elecdot/hardware-design/reports/README.md

# reports

这里存放课程报告输入材料、选题文档和图表。

## 索引

| 路径 | 用途 |
|---|---|
| [diagrams/](diagrams/) | 可编辑的架构和设计图。 |
| [final_defense_ppt_outline.md](final_defense_ppt_outline.md) | 最终答辩 PPT 大纲和 10 分钟硬件演示脚本。 |
| [i2c_jy901_midterm_ip_check.md](i2c_jy901_midterm_ip_check.md) | I2C JY901 模块的期中个人 IP 检查说明。 |
| [DOCX files](.) | 课程选题或报告文档。 |

仅用于报告表达的内容放在这里。会影响实现的工程事实应同步到 [../docs/](../docs/)。
