elecdot/hardware-design/reports/gzh/README.md

# gzh PPT materials

本目录包含可插入小组最终汇报的三段 PPT 源材料：

1. I2C JY901 九轴传感器。
2. PYNQ 侧融合与集成。
3. PC Server 侧集成服务。

文件：

| 文件 | 用途 |
|---|---|
| [ppt_three_sections.md](ppt_three_sections.md) | 三个部分可直接使用的 slide 文本和讲稿。 |
| [evidence_and_boundaries.md](evidence_and_boundaries.md) | 验证证据、demo 表述边界和可能的老师追问。 |
| [latex/](latex/) | 用于最终 PPT 图的 LaTeX/TikZ 源图。 |
| [diagrams/](diagrams/) | 作为轻量备份/参考保留的 Mermaid 源图。 |

这些文件有意不包含个人 overview 页和最终 summary 页，因为它们用于插入全组汇报流程。
