elecdot/hardware-design/reports/report/assert/README.md

# Report Image Asset Checklist

本目录存放报告正文引用的图片。

## 已存在

- `fig3-2-jy901-ip-architecture.png`
- `fig3-3-jy901-i2c-burst-read.svg`
- `fig3-1-jy901-single-module-path.svg`
- `fig3-5-jy901-pynq-driver-flow.svg`
- `fig3-8-jy901-ila-debug-top.svg`
- `fig3-11-pynq-software-integration.svg`
- `fig3-12-pc-service-module-design.svg`
- `fig4-2-system-architecture.svg`
- `fig4-5-pc-pynq-four-message-flow.svg`
- `fig4-6-pc-server-pipeline.svg`
- `fig4-7-board-client-sequence.svg`
- `fig4-8-system-test-layered-flow.svg`

其中部分文件复用了既有展示材料，新增的软件结构图为报告正文补充图。

## 仍需补充

- `fig3-4-vivado-jy901-ip-symbol.png`
- `fig3-6-jy901-simulation-pass.png`
- `fig3-7-jy901-i2c-waveform.png`
- `fig3-9-jy901-ila-debug-capture.png`
- `fig3-10-jy901-single-module-cli-pass.png`
- `fig4-1-final-system-photo.png`
- `fig4-3-vivado-block-design.png`
- `fig4-4-final-wiring-photo.png`
- `fig4-9-module-simulation-pass-summary.png`
- `fig4-10-vivado-address-map.png`
- `fig4-11-pynq-integrated-demo-output.png`
- `fig4-12-tft-live-dashboard-photo.png`
- `fig4-13-ir-ac-pynq-output.png`
- `fig4-14-ir-transmitter-ac-response-photo.png`
- `fig4-15-pc-dashboard-final-demo.png`
- `fig4-16-jsonl-four-record-streams.png`
- `fig4-17-final-demo-evidence-collage.png`
