elecdot/hardware-design/reports/diagrams/README.md

# diagrams

这里存放课程报告和设计说明使用的可编辑项目图。

## 索引

| 文件 | 用途 |
|---|---|
| [macro-design.drawio](macro-design.drawio) | 高层系统架构图。 |

当图表反映某个实现决策时，同步更新 [../../docs/](../../docs/) 中对应的文字文档。
