elecdot/hardware-design/vivado/ip_repo/ir_ac_axi/src/gree_ir_core.v

`timescale 1ns/1ns

/*
 * Raw Gree YB0F2 infrared transmit core.
 *
 * This core replays captured active-low mark/space waveforms for seven
 * 67-bit Gree YB0F2 commands. Software selects PRESET 1..7, then issues START.
 * The AXI command registers only expose the low 64 bits as compatibility
 * status; the actual transmitted waveform comes from this ROM.
 *
 * PRESET 1: power_on  0x1090040A400080016
 * PRESET 2: power_off 0x8050040A40008001C
 * PRESET 3: temp_24   0x9010040A400080016
 * PRESET 4: temp_25   0x9090040A40008000E
 * PRESET 5: temp_26   0x9050040A40008001E
 * PRESET 6: temp_27   0x90D0040A400080000
 * PRESET 7: temp_28   0x9030040A400080010
 */
module gree_ir_core #
(
    parameter integer CLK_FREQ   = 100_000_000,
    parameter integer CLK_1US    = 100,
    parameter integer CARRIER_HZ = 38_000
)
(
    input  wire        clk,
    input  wire        rst_n,
    input  wire        start,
    input  wire [2:0]  preset,
    output wire        busy,
    output reg         done,
    output reg         ir_pwm,
    output wire [3:0]  debug_state,
    output wire [9:0]  debug_bit_cnt
);

localparam integer CARRIER_CNT  = CLK_FREQ / CARRIER_HZ;
localparam integer CARRIER_HIGH = CARRIER_CNT / 3;
localparam integer SAMPLE_COUNT = 140;
localparam integer PRESET_COUNT = 7;
localparam integer TOTAL_SAMPLE_COUNT = 980;
localparam integer SAMPLE_CYCLES_WIDTH = 24;
localparam integer SAMPLE_ADDR_WIDTH = 10;

localparam [3:0] S_IDLE = 4'd0;
localparam [3:0] S_PLAY = 4'd1;

(* rom_style = "block" *) reg [SAMPLE_CYCLES_WIDTH-1:0] sample_cycles_rom [0:TOTAL_SAMPLE_COUNT-1];

initial begin
        // preset 1: power_on (0x1090040A400080016)
        sample_cycles_rom[0] = 24'd903500;
        sample_cycles_rom[1] = 24'd446400;
        sample_cycles_rom[2] = 24'd67700;
        sample_cycles_rom[3] = 24'd53000;
        sample_cycles_rom[4] = 24'd67600;
        sample_cycles_rom[5] = 24'd52900;
        sample_cycles_rom[6] = 24'd67700;
        sample_cycles_rom[7] = 24'd53000;
        sample_cycles_rom[8] = 24'd67700;
        sample_cycles_rom[9] = 24'd165300;
        sample_cycles_rom[10] = 24'd65400;
        sample_cycles_rom[11] = 24'd53000;
        sample_cycles_rom[12] = 24'd67600;
        sample_cycles_rom[13] = 24'd53100;
        sample_cycles_rom[14] = 24'd67500;
        sample_cycles_rom[15] = 24'd52900;
        sample_cycles_rom[16] = 24'd67700;
        sample_cycles_rom[17] = 24'd53000;
        sample_cycles_rom[18] = 24'd70200;
        sample_cycles_rom[19] = 24'd163100;
        sample_cycles_rom[20] = 24'd65400;
        sample_cycles_rom[21] = 24'd53000;
        sample_cycles_rom[22] = 24'd67600;
        sample_cycles_rom[23] = 24'd52900;
        sample_cycles_rom[24] = 24'd67600;
        sample_cycles_rom[25] = 24'd165500;
        sample_cycles_rom[26] = 24'd65300;
        sample_cycles_rom[27] = 24'd53000;
        sample_cycles_rom[28] = 24'd67700;
        sample_cycles_rom[29] = 24'd53000;
        sample_cycles_rom[30] = 24'd67700;
        sample_cycles_rom[31] = 24'd53000;
        sample_cycles_rom[32] = 24'd67500;
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
        sample_cycles_rom[934] = 24'd67500;
        sample_cycles_rom[935] = 24'd53100;
        sample_cycles_rom[936] = 24'd67600;
        sample_cycles_rom[937] = 24'd53200;
        sample_cycles_rom[938] = 24'd67400;
        sample_cycles_rom[939] = 24'd53100;
        sample_cycles_rom[940] = 24'd67400;
        sample_cycles_rom[941] = 24'd163300;
        sample_cycles_rom[942] = 24'd67600;
        sample_cycles_rom[943] = 24'd53200;
        sample_cycles_rom[944] = 24'd67300;
        sample_cycles_rom[945] = 24'd53200;
        sample_cycles_rom[946] = 24'd67400;
        sample_cycles_rom[947] = 24'd53300;
        sample_cycles_rom[948] = 24'd67400;
        sample_cycles_rom[949] = 24'd53200;
        sample_cycles_rom[950] = 24'd67400;
        sample_cycles_rom[951] = 24'd53100;
        sample_cycles_rom[952] = 24'd67500;
        sample_cycles_rom[953] = 24'd53100;
        sample_cycles_rom[954] = 24'd67600;
        sample_cycles_rom[955] = 24'd53200;
        sample_cycles_rom[956] = 24'd67400;
        sample_cycles_rom[957] = 24'd53100;
        sample_cycles_rom[958] = 24'd67600;
        sample_cycles_rom[959] = 24'd53300;
        sample_cycles_rom[960] = 24'd67500;
        sample_cycles_rom[961] = 24'd53100;
        sample_cycles_rom[962] = 24'd67600;
        sample_cycles_rom[963] = 24'd53100;
        sample_cycles_rom[964] = 24'd67500;
        sample_cycles_rom[965] = 24'd53000;
        sample_cycles_rom[966] = 24'd67500;
        sample_cycles_rom[967] = 24'd53000;
        sample_cycles_rom[968] = 24'd67600;
        sample_cycles_rom[969] = 24'd53100;
        sample_cycles_rom[970] = 24'd67700;
        sample_cycles_rom[971] = 24'd163200;
        sample_cycles_rom[972] = 24'd67600;
        sample_cycles_rom[973] = 24'd53100;
        sample_cycles_rom[974] = 24'd67600;
        sample_cycles_rom[975] = 24'd53100;
        sample_cycles_rom[976] = 24'd67600;
        sample_cycles_rom[977] = 24'd53000;
        sample_cycles_rom[978] = 24'd67700;
        sample_cycles_rom[979] = 24'd12000000;
end

function [SAMPLE_ADDR_WIDTH-1:0] preset_base;
    input [2:0] preset_id;
    begin
        case(preset_id)
        3'd1: preset_base = 10'd0;
        3'd2: preset_base = 10'd140;
        3'd3: preset_base = 10'd280;
        3'd4: preset_base = 10'd420;
        3'd5: preset_base = 10'd560;
        3'd6: preset_base = 10'd700;
        3'd7: preset_base = 10'd840;
        default: preset_base = 10'd0;
        endcase
    end
endfunction

function [2:0] sanitize_preset;
    input [2:0] preset_id;
    begin
        if(preset_id >= 3'd1 && preset_id <= 3'd7)
            sanitize_preset = preset_id;
        else
            sanitize_preset = 3'd1;
    end
endfunction

reg [3:0]  curr_state;
reg [31:0] cnt;
reg [9:0]  sample_index;
reg [SAMPLE_CYCLES_WIDTH-1:0] sample_cycles;
reg [31:0] cnt_carrier;
reg        carrier;
reg [2:0]  active_preset;

wire sample_mark;
wire sample_done;
wire start_accept;
wire [2:0] requested_preset;
wire [SAMPLE_ADDR_WIDTH-1:0] active_base;
wire [SAMPLE_ADDR_WIDTH-1:0] requested_base;

assign busy = (curr_state != S_IDLE);
assign debug_state = curr_state;
assign debug_bit_cnt = sample_index;
assign start_accept = start && !busy;
assign sample_mark = (sample_index[0] == 1'b0);
assign sample_done = (cnt >= sample_cycles - 1'b1);
assign requested_preset = sanitize_preset(preset);
assign active_base = preset_base(active_preset);
assign requested_base = preset_base(requested_preset);

always @(posedge clk or negedge rst_n) begin
    if(!rst_n) begin
        cnt_carrier <= 0;
        carrier <= 1'b0;
    end else if(curr_state == S_IDLE) begin
        cnt_carrier <= 0;
        carrier <= 1'b0;
    end else if(cnt_carrier >= CARRIER_CNT - 1) begin
        cnt_carrier <= 0;
        carrier <= 1'b0;
    end else begin
        cnt_carrier <= cnt_carrier + 1'b1;
        carrier <= (cnt_carrier < CARRIER_HIGH);
    end
end

always @(posedge clk or negedge rst_n) begin
    if(!rst_n) begin
        curr_state <= S_IDLE;
        cnt <= 0;
        sample_index <= 0;
        sample_cycles <= 0;
        active_preset <= 3'd1;
        ir_pwm <= 1'b0;
        done <= 1'b0;
    end else begin
        ir_pwm <= 1'b0;
        done <= 1'b0;

        case(curr_state)
            S_IDLE: begin
                cnt <= 0;
                sample_index <= 0;
                if(start_accept) begin
                    active_preset <= requested_preset;
                    sample_cycles <= sample_cycles_rom[requested_base];
                    curr_state <= S_PLAY;
                end
            end

            S_PLAY: begin
                if(sample_mark)
                    ir_pwm <= carrier;

                if(sample_done) begin
                    cnt <= 0;
                    if(sample_index == SAMPLE_COUNT - 1) begin
                        sample_index <= 0;
                        sample_cycles <= sample_cycles_rom[active_base];
                        curr_state <= S_IDLE;
                        done <= 1'b1;
                    end else begin
                        sample_index <= sample_index + 1'b1;
                        sample_cycles <= sample_cycles_rom[active_base + sample_index + 1'b1];
                    end
                end else begin
                    cnt <= cnt + 1'b1;
                end
            end

            default: begin
                curr_state <= S_IDLE;
                cnt <= 0;
                sample_index <= 0;
                sample_cycles <= 0;
                active_preset <= 3'd1;
            end
        endcase
    end
end

endmodule
