elecdot/hardware-design/rtl/i2c_mpu9250/i2c_open_drain_io.v

`timescale 1ns / 1ps

module i2c_open_drain_io (
    input  wire scl_drive_low,
    input  wire sda_drive_low,
    inout  wire i2c_scl,
    inout  wire i2c_sda,
    output wire scl_in,
    output wire sda_in
);
`ifdef SYNTHESIS
    IOBUF #(
        .DRIVE(12),
        .IBUF_LOW_PWR("TRUE"),
        .IOSTANDARD("LVCMOS33"),
        .SLEW("SLOW")
    ) u_i2c_scl_iobuf (
        .I(1'b0),
        .O(scl_in),
        .T(~scl_drive_low),
        .IO(i2c_scl)
    );

    IOBUF #(
        .DRIVE(12),
        .IBUF_LOW_PWR("TRUE"),
        .IOSTANDARD("LVCMOS33"),
        .SLEW("SLOW")
    ) u_i2c_sda_iobuf (
        .I(1'b0),
        .O(sda_in),
        .T(~sda_drive_low),
        .IO(i2c_sda)
    );
`else
    assign i2c_scl = scl_drive_low ? 1'b0 : 1'bz;
    assign i2c_sda = sda_drive_low ? 1'b0 : 1'bz;

    assign scl_in = i2c_scl;
    assign sda_in = i2c_sda;
`endif
endmodule
