elecdot/hardware-design/(commit log)

2026-04-28 feat(i2c): full i2c-axi-mpu9250 v1.0 implement
2026-05-08 test(i2c): add AXI top tb and critical path check
2026-05-11 docs: move i2c waveform observation into single doc
2026-05-11 feat(i2c): jy901 hw debug
2026-05-12 fix(jy901_hw_debug): ILA probe clock domain infer error
    [jy901_hw_debug_top.v]
2026-05-12 fear: run full vivado dev flow
2026-05-12 fix: add IOBUF clarify for open drain i2c
    [i2c_open_drain_io.v]
2026-05-15 fix(i2c): jy901_hw_debug_top
2026-05-20 feat(i2c): axi_i2c_jy901 ip packaged
2026-05-20 feat(i2c): axi_i2c_jy901 ip bitstream generated
2026-05-20 docs(repo): full post i2c ip documentation align
2026-05-20 feat(i2c): i2c PYNQ smoke demo
2026-05-21 chore(report): i2c jy901 midterm ip check
2026-05-21 feat(i2c): i2c PYNQ smoke demo v1.0
2026-06-01 chore: mark a complex simulation like i2c is not convention
2026-06-02 feat(tft): migrate LCD SPI handoff skeleton
2026-06-02 feat(spo2): migrate UART handoff skeleton
2026-06-02 feat(pc-server): migrate socket handoff demo
2026-06-03 feat(repo): pacakge humidifier uart dht11 and spi tft
2026-06-12 feat(pc): add minimal socket protocol loop
2026-06-12 feat(pynq): add board orchestrator skeleton
2026-06-12 feat(pynq): add board socket client skeleton
2026-06-16 report: final ppt materials gzh
2026-06-22 report: detailed i2c jy901
